bmirvish/G4_TechWatch/README.md

# G4_TechWatch
Smartwatch Milestone 2022
