bmirvish/G4_TechWatch/Watch_Features.docx

This watch will provide an OLED Display, Power LED, Gyroscope, Beeper, Pushbuttons, and Bluetooth
