bmirvish/G4_TechWatch/Hardware/Basic/G4_TechWatch-BASIC-BOM.xlsx

Design Name -- Revision Code / Designer or Organization Name |  |  |  |  |  |  |  |  |  |  | Total | $24.71 | Total (in Bulk) | $19.47
BOM # | Comment | Designator | Description | Mounting Type | Package | Manufacturer | Manufacturer Part Number | Supplier | Supplier Part Number | Price per unit | Quantity | Total | Per 100 | Total
1 | NRF52832 | U1 | BLE Capable Microcontroller | SMD | 41-SMD Module | Raytac | MDBT42Q-512KV2 | Digi-Key | 3271-MDBT42Q-512KV2-ND | $9.90 | 1 | $9.90 | $9.90 | $9.90
2 | Tiny Rectangular Switch | SW1,SW2 | Tactile Switch SPST-NO Top Actuated Surface Mount | SMD | Gull Wing | C&K Components | PTS830GM140 SMTR LFS | Digi-Key | CKN10587CT-ND | $0.71 | 2 | $1.42 | $0.57 | $1.14
3 | SWITCH.MOM (TACTILE_SWITCH_SMD_6.2MM_TALL) | SW3,SW4,SW5 | Tactile Switch SPST-NO Top Actuated Surface Mount - TACT 4.5 X 4.5, 5.0 MM H, 1.0N, | SMD | Gull Wing | C&K | PTS 647 SN50 SMTR2 LFS | Digi-Key | PTS647SN50SMTR2LFSCT-ND | $0.21 | 3 | $0.63 | $0.17 | $0.51
4 | 10uH Inductor | L1 | 10µH Shielded Multilayer Inductor 250mA 1.05Ohm 0603 (1608 Metric) | SMD | 0603 | TDK Corporation | MLZ1608M100WTD25 | Digi-Key | MLZ1608M100WTD25 | $0.20 | 1 | $0.20 | $0.12 | $0.12
5 | 10k resistor | R1,R2,R6,R10,R11 | 10 kOhms ±1% 0.1W, 1/10W Chip Resistor 0603 (1608 Metric) Automotive AEC-Q200 Thick Film | SMD | 0603 | Stackpole Electronics Inc | RMCF0603FT10K0 | Digi-Key | RMCF0603FT10K0CT-ND | $0.10 | 5 | $0.50 | $0.01 | $0.03
6 | 1uF capacitor | C1,C8,C9,C18 | 1µF ±10% 25V Ceramic Capacitor X5R 0603 (1608 Metric) | SMD | 0603 | Samsung Electro-Mechanics | CL10A105KA8NNNC | Digi-Key | 1276-1102-1-ND | $0.10 | 4 | $0.40 | $0.01 | $0.04
7 | 100k resistor | R3,R7,R8,R9 | 100 kOhms ±1% 0.1W, 1/10W Chip Resistor 0603 (1608 Metric) Automotive AEC-Q200 Thick Film | SMD | 0603 | Stackpole Electronics Inc | RMCF0603FT100K | Digi-Key | RMCF0603FT100KCT-ND | $0.10 | 4 | $0.40 | $0.01 | $0.02
8 | 1k resistor | R4,R5 | 1 kOhms ±1% 0.1W, 1/10W Chip Resistor 0603 (1608 Metric) Automotive AEC-Q200 Thick Film | SMD | 0603 | Stackpole Electronics Inc | RMCF0603FT1K00 | Digi-Key | RMCF0603FT1K00CT-ND | $0.10 | 2 | $0.20 | $0.01 | $0.02
9 | 390k resistor | R12 | 390 kOhms ±1% 0.1W, 1/10W Chip Resistor 0603 (1608 Metric) Automotive AEC-Q200 Thick Film | SMD | 0603 | Stackpole Electronics Inc | RMCF0603FG390K | Digi-Key | RMCF0603FG390KCT-ND | $0.16 | 1 | $0.16 | $0.05 | $0.05
11 | 10uF capacitor | C2,C12 | 10 µF ±10% 25V Ceramic Capacitor X5R 0805 (2012 Metric) | SMD | 0805 | KYOCERA AVX | 08053D106KAT4A | Digi-Key | 478-08053D106KAT4ATR-ND | $0.44 | 2 | $0.88 | $0.20 | $0.40
12 | 300pF capacitor | C5,C6 | 300 pF ±10% 50V Ceramic Capacitor X7R 0603 (1608 Metric) | SMD | 0603 | Yageo | CC0603KRX7R9BB301 | Digi-Key | 13-CC0603KRX7R9BB301CT-ND | $0.10 | 2 | $0.20 | $0.03 | $0.06
13 | 4.7uF capacitor | C7,C10 | 4.7 µF ±10% 16V Ceramic Capacitor X5R 0603 (1608 Metric) | SMD | 0603 | Samsung Electro-Mechanics | CL10A475KO8NNNC | Digi-Key | 1276-1784-1-ND | $0.12 | 2 | $0.24 | $0.04 | $0.08
14 | 100nF capacitor | C11 | 0.1µF ±5% 16V Ceramic Capacitor X7R 0603 (1608 Metric) | SMD | 0603 | Yageo | CC0603JRX7R7BB104 | Digi-Key | 311-1776-1-ND | $0.10 | 1 | $0.10 | $0.03 | $0.03
15 | 12pF capacitor | C3, C4 | 12pF ±5% 50V Ceramic Capacitor C0G, NP0 0603 (1608 Metric) | SMD | 0603 | Walsin Technology Corporation | 0603N120J500CT | Digi-Key | 1292-1480-1-ND | $0.10 | 2 | $0.20 | $0.01 | $0.02
16 | 32.768kHz Oscillator | XTAL1, XTAL2 | 32.768kHz ±10ppm Crystal 12.5pF 90 kOhms 2-SMD, No Lead | SMD | 2-SMD, No Lead | ECS Inc. | ECS-.327-12.5-12-C-TR | Digi-Key | XC2288CT-ND | $0.83 | 2 | $1.66 | $0.61 | $1.22
17 | Red LED | LED1 | Red 622nm LED Indication - Discrete 2.2V 0603 (1608 Metric) | SMD | 0603 | Inolux | IN-S63ATR | Digi-Key | 1830-1065-1-ND | $0.33 | 1 | $0.33 | $0.08 | $0.08
18 | BLUE SMD LED | LED2 | Blue 470nm LED Indication - Discrete 3V 0603 (1608 Metric) | SMD | 0603 | Inolux | IN-S63AT5B | Digi-Key | 1830-1061-1-ND | $0.33 | 1 | $0.33 | $0.08 | $0.08
19 | 0.96" OLED | OLED | Datasheet 128x64 OLED Module SPI 0.96"Graphic Displays,White on Black | SMD | Flexible Connector | EastRising | https://www.buydisplay.com/datasheet-128x64-oled-module-spi-0-96-inch-graphic-displays-white-on-black | BuyDisplay.com | https://www.buydisplay.com/datasheet-128x64-oled-module-spi-0-96-inch-graphic-displays-white-on-black | $2.51 | 1 | $2.51 | $2.51 | $2.51
20 | Cortex Debug Connector - 10 pin | DEBUG1 | Connector Header Through Hole 10 position 0.050" (1.27mm) | THT | NA | Amphenol ICC (FCI) | 20021111-00010T4LF | Digi-Key | 609-3712-ND | $0.79 | 1 | $0.79 | $0.69 | $0.69
21 | Schottky Diode | D1,D2,D3 | Diode Schottky 30V 1.5A Surface Mount USC | SMD | USC | Toshiba Semiconductor and Storage | CUS15S30,H3F | Digi-Key | CUS15S30H3FCT-ND | $0.37 | 3 | $1.11 | $0.16 | $0.48
22 | PCF8523 | U2 | Real Time Clock (RTC) IC Clock/Calendar I²C, 2-Wire Serial 8-SOIC (0.154", 3.90mm Width) | SMD | 8-SO | NXP USA Inc. | PCF8523T/1,118 | Digi-Key | 568-5306-1-ND | $1.63 | 1 | $1.63 | $1.17 | $1.17
23 | MIC5504-3.3V | LDO1 | Linear Voltage Regulator IC 1 Output 300mA SOT-23-5 | SMD | SOT23-5 | Microchip Technology | MIC5504-3.3YM5-TR | Digi-Key | 576-4764-1-ND | $0.16 | 1 | $0.16 | $0.12 | $0.12
24 | MCP73831 T Li-Ion, Li-Pol Controller | CHRG1 | Charger IC Lithium-Ion/Polymer SOT-23-5 | SMD | SOT-23-5 | Microchip Technology | MCP73831T-2ACI/OT | Digi-Key | MCP73831T-2ACI/OTCT-ND | $0.76 | 1 | $0.76 | $0.69 | $0.69
25 |  | J1 |  |  |  |  |  |  |  |  | 1 | $0.00 |  | $0.00
26 |  | J2 |  |  |  |  |  |  |  |  | 1 | $0.00 |  | $0.00
