bmirvish/G4_TechWatch/Hardware/Basic/G4_TechWatch-BASIC.brd

## EAGLE design Hardware/Basic/G4_TechWatch-BASIC.brd (2022-10-19)

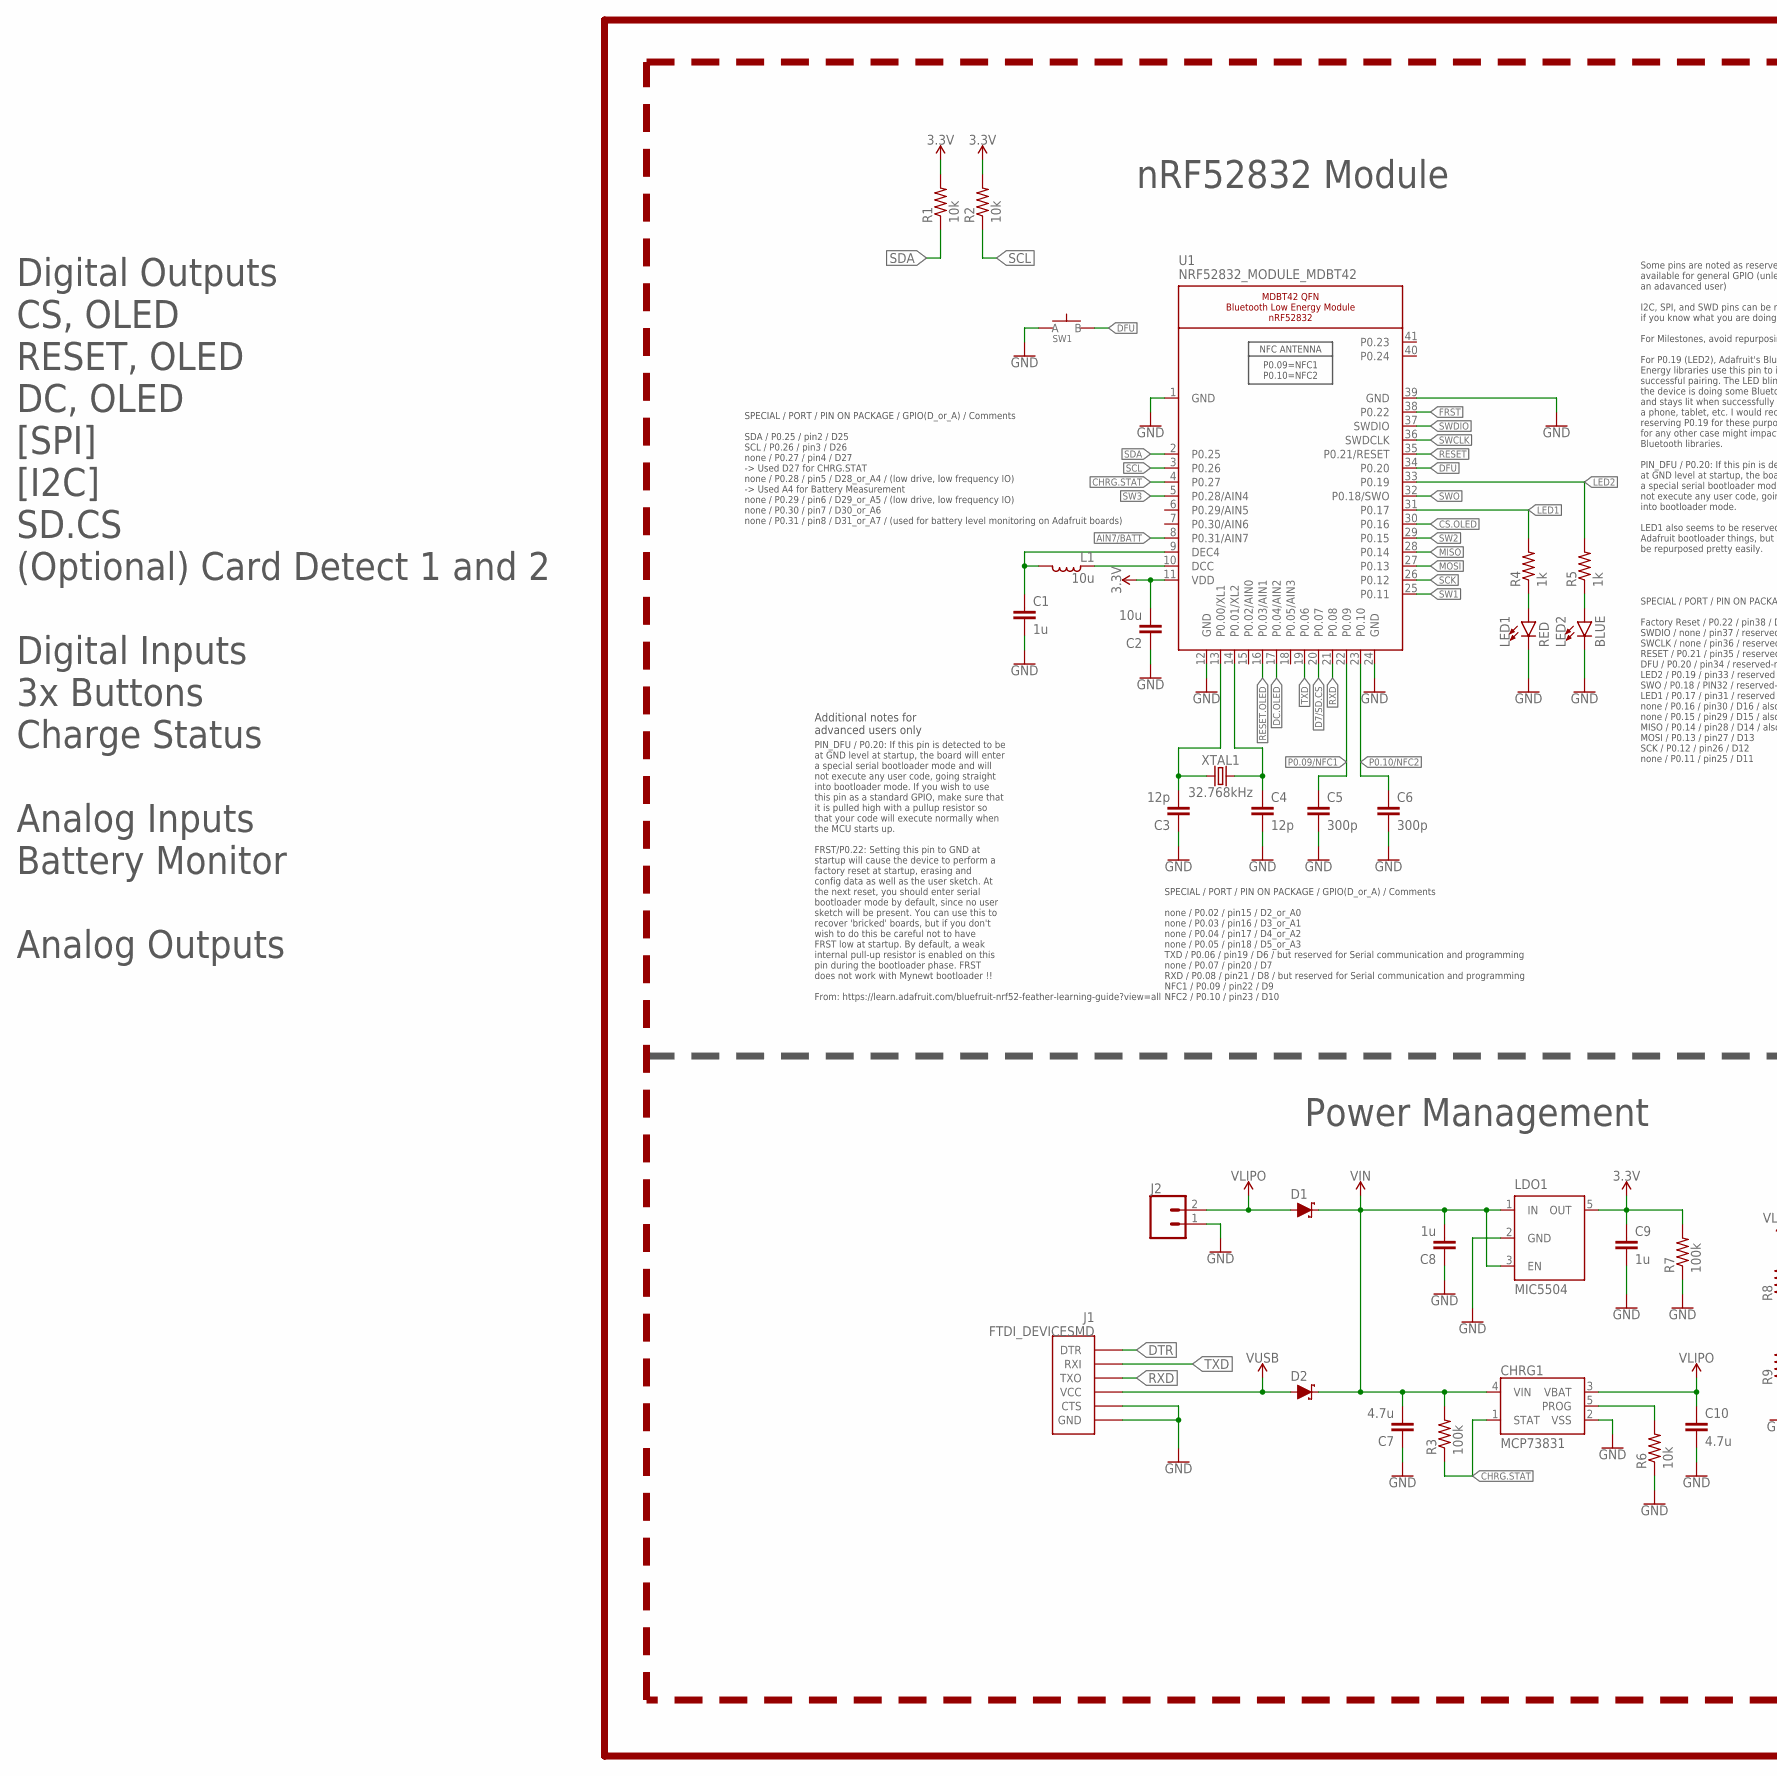
[picture p1: schematic G4_TechWatch-BASIC.sch, part in row 1, column 1]

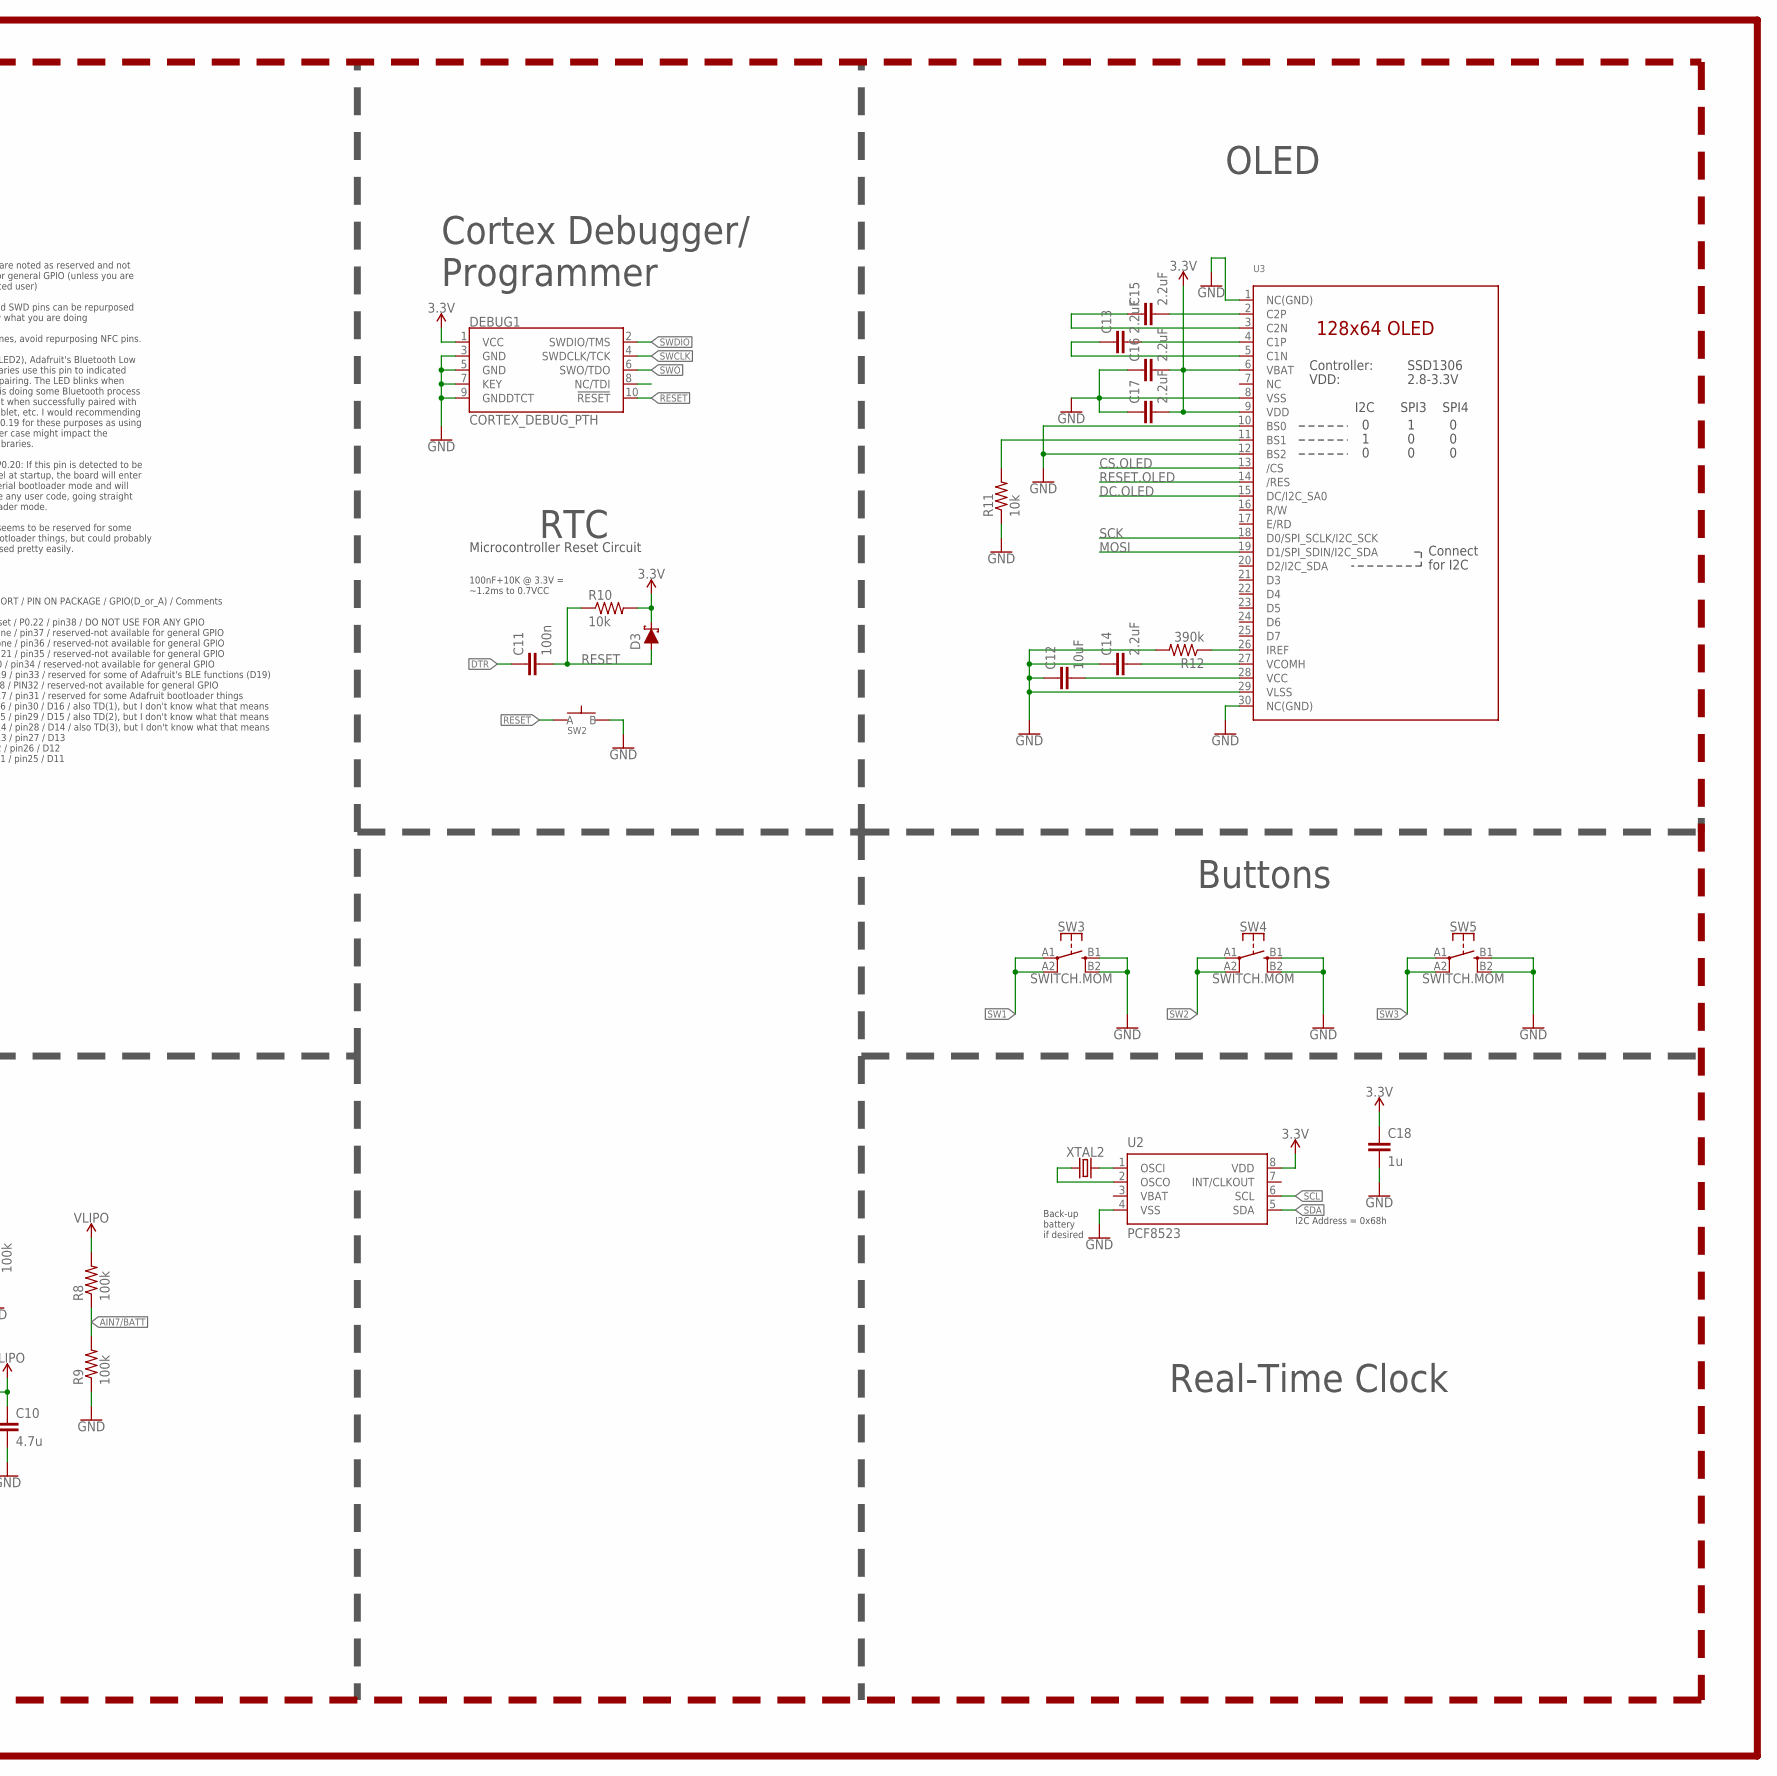
[picture p2: schematic G4_TechWatch-BASIC.sch, part in row 1, column 2]

Parts:
C1, C8, C9, C18: 1u; C0603
C2: 10u; C0805
C3, C4: 12p; C0603
C5, C6: 300p; C0603
C7, C10: 4.7u; C0603
C11: 100n; C0603
C12: 10uF; C0603
C13, C14, C15, C16, C17: 2.2uF; C0402
CHRG1: MCP73831; SOT23-5
D1, D2, D3: SCHOTTKY-USC; USC
DEBUG1: CORTEX_DEBUG_PTH; 2X5-PTH-1.27MM
J1: FTDI_DEVICESMD; FTDI-SMD
J2: CONN_02; 1X02
L1: 10u; L0603
LDO1: MIC5504; SOT23-5
LED1: RED; LED-0603
LED2: BLUE; LED-0603
R1, R2, R6, R10, R11: 10k; R0603
R3, R7, R8, R9: 100k; R0603
R4, R5: 1k; R0603
R12: 390k; R0603
SW1, SW2: SPST-PTS830GG140-COPY.1-3; BUTTON-GULLWING
SW3, SW4, SW5: SWITCH.MOM; TACTILE_SWITCH_SMD_6.2MM_TALL
U1: NRF52832_MODULE_MDBT42; BLE_MODULE_RAYTAC_MDBT42
U2: PCF8523; SO8; DIGIKEY 568-5306-1-ND
U3: DISP_OLED_UG-2864HSWEG01-NO-WRAPAROUND; UG-2864HSWEG01_0.96IN_NO-WRAPAROUND
XTAL1: 32.768kHz; 2-SMD.NOLEAD.2.0MMTO1.2MM
XTAL2: 32.7680kHz; 2-SMD.NOLEAD.2.0MMTO1.2MM

Connections:
3.3V: C2.2, C9.1, C16.2, C17.2, C18.1, D3.- (C), DEBUG1.1 (VCC), LDO1.5 (OUT), R1.2, R2.2, R7.2, R10.2, U1.11 (VDD), U2.8 (VDD), U3.6 (VBAT), U3.9 (VDD)
AIN7/BATT: R8.1, R9.2, U1.8 (P0.31/AIN7)
CHRG.STAT: CHRG1.1 (STAT), R3.1, U1.4 (P0.27)
CS.OLED: U1.30 (P0.16), U3.13 (/CS)
D7/SD.CS: U1.20 (P0.07)
DC.OLED: U1.17 (P0.04/AIN2), U3.15 (DC/I2C_SA0)
DFU: SW1.3 (B), U1.34 (P0.20)
DTR: C11.1, J1.DTR
FRST: U1.38 (P0.22)
GND: C1.2, C2.1, C3.1, C4.2, C5.2, C6.2, C7.1, C8.1, C9.2, C10.2, C12.1, C14.1, C16.1, C17.1, C18.2, CHRG1.2 (VSS), DEBUG1.3 (GND), DEBUG1.5 (GND), DEBUG1.7 (KEY), DEBUG1.9 (GNDDTCT), J1.CTS, J1.GND, J2.1, LDO1.2 (GND), LED1.C, LED2.C, R6.1, R7.1, R9.1, R11.1, R12.2, SW1.1 (A), SW2.3 (B), SW3.B1 (3), SW3.B2 (4), SW4.B1 (3), SW4.B2 (4), SW5.B1 (3), SW5.B2 (4), U1.1 (GND), U1.12 (GND), U1.24 (GND), U1.39 (GND), U2.4 (VSS), U3.1 (NC(GND)), U3.8 (VSS), U3.10 (BS0), U3.12 (BS2), U3.29 (VLSS), U3.30 (NC(GND))
LED1: R4.2, U1.31 (P0.17)
LED2: R5.2, U1.33 (P0.19)
MISO: U1.28 (P0.14)
MOSI: U1.27 (P0.13), U3.19 (D1/SPI_SDIN/I2C_SDA)
unnamed: R11.2, U3.11 (BS1)
unnamed: R12.1, U3.26 (IREF)
unnamed: C15.2, U3.2 (C2P)
unnamed: C3.2, U1.13 (P0.00/XL1), XTAL1.P$1 (1)
unnamed: C15.1, U3.3 (C2N)
unnamed: C4.1, U1.14 (P0.01/XL2), XTAL1.P$2 (2)
unnamed: C13.2, U3.4 (C1P)
unnamed: C13.1, U3.5 (C1N)
unnamed: LED1.A, R4.1
unnamed: LED2.A, R5.1
unnamed: L1.1, U1.10 (DCC)
unnamed: C1.1, L1.2, U1.9 (DEC4)
unnamed: C12.2, U3.28 (VCC)
unnamed: C14.2, U3.27 (VCOMH)
unnamed: CHRG1.5 (PROG), R6.2
unnamed: U2.2 (OSCO), XTAL2.P$1 (1)
unnamed: U2.1 (OSCI), XTAL2.P$2 (2)
P0.09/NFC1: C5.1, U1.22 (P0.09)
P0.10/NFC2: C6.1, U1.23 (P0.10)
RESET: C11.2, D3.+ (A), DEBUG1.10 (!RESET), R10.1, SW2.1 (A), U1.35 (P0.21/RESET)
RESET.OLED: U1.16 (P0.03/AIN1), U3.14 (/RES)
RXD: J1.TXO, U1.21 (P0.08)
SCK: U1.26 (P0.12), U3.18 (D0/SPI_SCLK/I2C_SCK)
SCL: R2.1, U1.3 (P0.26), U2.6 (SCL)
SDA: R1.1, U1.2 (P0.25), U2.5 (SDA)
SW1: SW3.A1 (1), SW3.A2 (2), U1.25 (P0.11)
SW2: SW4.A1 (1), SW4.A2 (2), U1.29 (P0.15)
SW3: SW5.A1 (1), SW5.A2 (2), U1.5 (P0.28/AIN4)
SWCLK: DEBUG1.4 (SWDCLK/TCK), U1.36 (SWDCLK)
SWDIO: DEBUG1.2 (SWDIO/TMS), U1.37 (SWDIO)
SWO: DEBUG1.6 (SWO/TDO), U1.32 (P0.18/SWO)
TXD: J1.RXI, U1.19 (P0.06)
VBAT: U2.3 (VBAT)
VIN: C7.2, C8.2, CHRG1.4 (VIN), D1.- (C), D2.- (C), LDO1.1 (IN), LDO1.3 (EN), R3.2
VLIPO: C10.1, CHRG1.3 (VBAT), D1.+ (A), J2.2, R8.2
V_USB: D2.+ (A), J1.VCC

Notes on the sheet:
Microcontroller Reset Circuit
100nF+10K @ 3.3V = ~1.2ms to 0.7VCC
SPECIAL / PORT / PIN ON PACKAGE / GPIO(D_or_A) / Comments SDA / P0.25 / pin2 / D25 SCL / P0.26 / pin3 / D26 none / P0.27 / pin4 / D27 -> Used D27 for CHRG.STAT none / P0.28 / pin5 / D28_or_A4 / (low drive, low frequency IO) -> Used A4 for Battery Measurement none / P0.29 / pin6 / D29_or_A5 / (low d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
SPECIAL / PORT / PIN ON PACKAGE / GPIO(D_or_A) / Comments none / P0.02 / pin15 / D2_or_A0 none / P0.03 / pin16 / D3_or_A1 none / P0.04 / pin17 / D4_or_A2 none / P0.05 / pin18 / D5_or_A3 TXD / P0.06 / pin19 / D6 / but reserved for Serial communication and programming none / P0.07 / pin20 / D7 RXD / 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
SPECIAL / PORT / PIN ON PACKAGE / GPIO(D_or_A) / Comments Factory Reset / P0.22 / pin38 / DO NOT USE FOR ANY GPIO SWDIO / none / pin37 / reserved-not available for general GPIO SWCLK / none / pin36 / reserved-not available for general GPIO RESET / P0.21 / pin35 / reserved-not available for general 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
Some pins are noted as reserved and not available for general GPIO (unless you are an adavanced user) I2C, SPI, and SWD pins can be repurposed if you know what you are doing For Milestones, avoid repurposing NFC pins. For P0.19 (LED2), Adafruit's Bluetooth Low Energy libraries use this pin to indic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
PIN_DFU / P0.20: If this pin is detected to be at GND level at startup, the board will enter a special serial bootloader mode and will not execute any user code, going straight into bootloader mode. If you wish to use this pin as a standard GPIO, make sure that it is pulled high with a pullup resis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
Additional notes for advanced users only
I2C Address = 0x68h
Back-up battery if desired
nRF52832 Module
OLED
Power Management
Buttons
Real-Time Clock
Cortex Debugger/ Programmer
RTC
Digital Outputs CS, OLED RESET, OLED DC, OLED [SPI] [I2C] SD.CS (Optional) Card Detect 1 and 2 Digital Inputs 3x Buttons Charge Status Analog Inputs Battery Monitor Analog Outputs

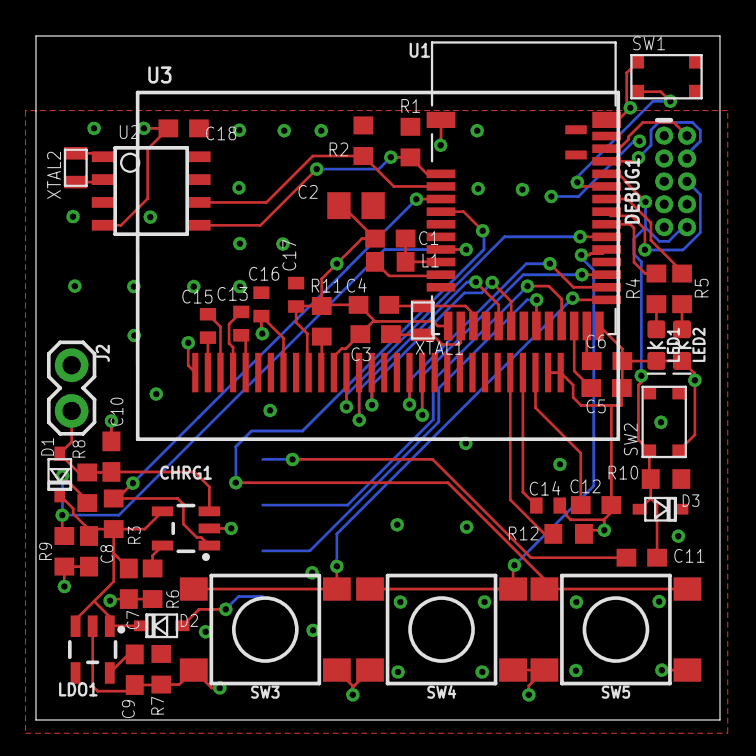
[picture p3: board G4_TechWatch-BASIC.brd from above]

Board: 2 copper layers, 38.0 x 38.0 mm, 51 parts (1 on the bottom side), 46 nets.
