bmirvish/G4_TechWatch/(commit log)

2022-09-12 Initial Setup Commit
    [G4_TechWatch-BASIC-BOM.xlsx, G4_TechWatch-BASIC.brd, G4_TechWatch-BASIC.sch]
2022-09-14 First Save Point for Board
    [G4_TechWatch-BASIC.brd, G4_TechWatch-BASIC.sch]
2022-09-15 End Of Class Schematic
    [G4_TechWatch-BASIC.brd, G4_TechWatch-BASIC.sch]
2022-09-21 Updated Schematics
    [G4_TechWatch-BASIC.brd, G4_TechWatch-BASIC.sch, G4_TechWatch-BOTTOM.brd, G4_TechWatch-BOTTOM.sch]
2022-09-21 Removed Bottom Board
    [G4_TechWatch-BOTTOM.brd, G4_TechWatch-BOTTOM.sch]
2022-09-21 Schematic Step 1 Done
    [G4_TechWatch-BASIC.brd, G4_TechWatch-BASIC.sch]
2022-09-22 End of Class 09/21/2022
    [G4_TechWatch-BASIC.brd, G4_TechWatch-BASIC.sch]
2022-09-28 Weekly commit for class
    [G4_TechWatch-BASIC.brd]
2022-09-28 Commit before leaving class
    [G4_TechWatch-BASIC.brd, G4_TechWatch-BASIC.sch]
2022-10-04 Board Completed
    [G4_TechWatch-BASIC.brd, G4_TechWatch-BASIC.sch]
2022-10-05 Added Ground Vias
    [G4_TechWatch-BASIC.brd]
2022-10-19 Added Missing values, fixed silkscreen and OLED spacing
    [G4_TechWatch-BASIC-BOM.xlsx, G4_TechWatch-BASIC.brd, G4_TechWatch-BASIC.sch]
2022-10-26 BOM Ver 1 Finished
    [G4_TechWatch-BASIC-BOM.xlsx]
2022-10-26 Added missing parts
    [G4_TechWatch-BASIC-BOM.xlsx]
